jenschr/Teensy3.6-example/datasheets/T3.6_schematic.png

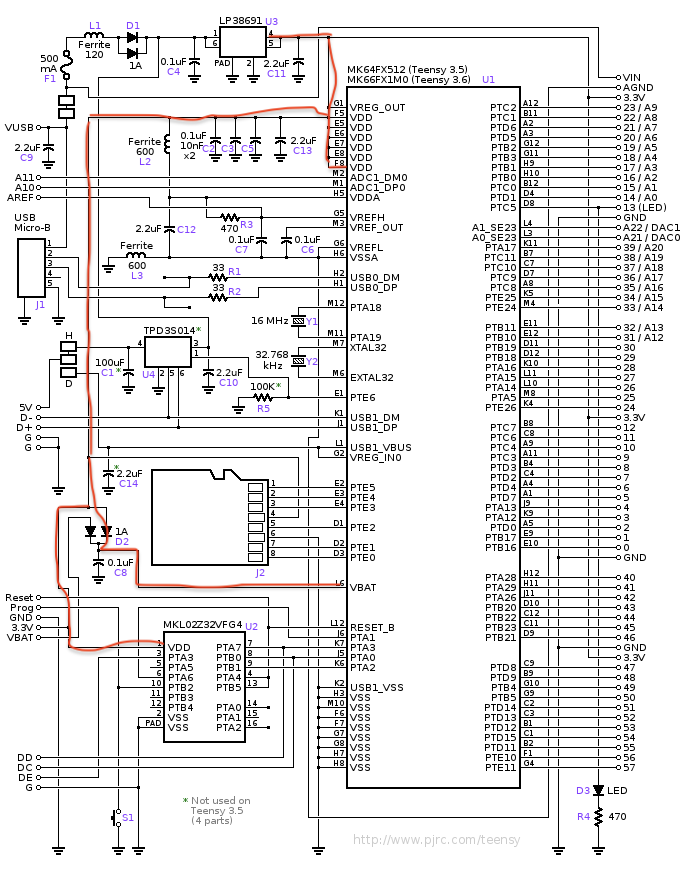
datasheets/T3.6_schematic.png
