jenschr/Teensy3.6-example/T3.6_schematic.pdf

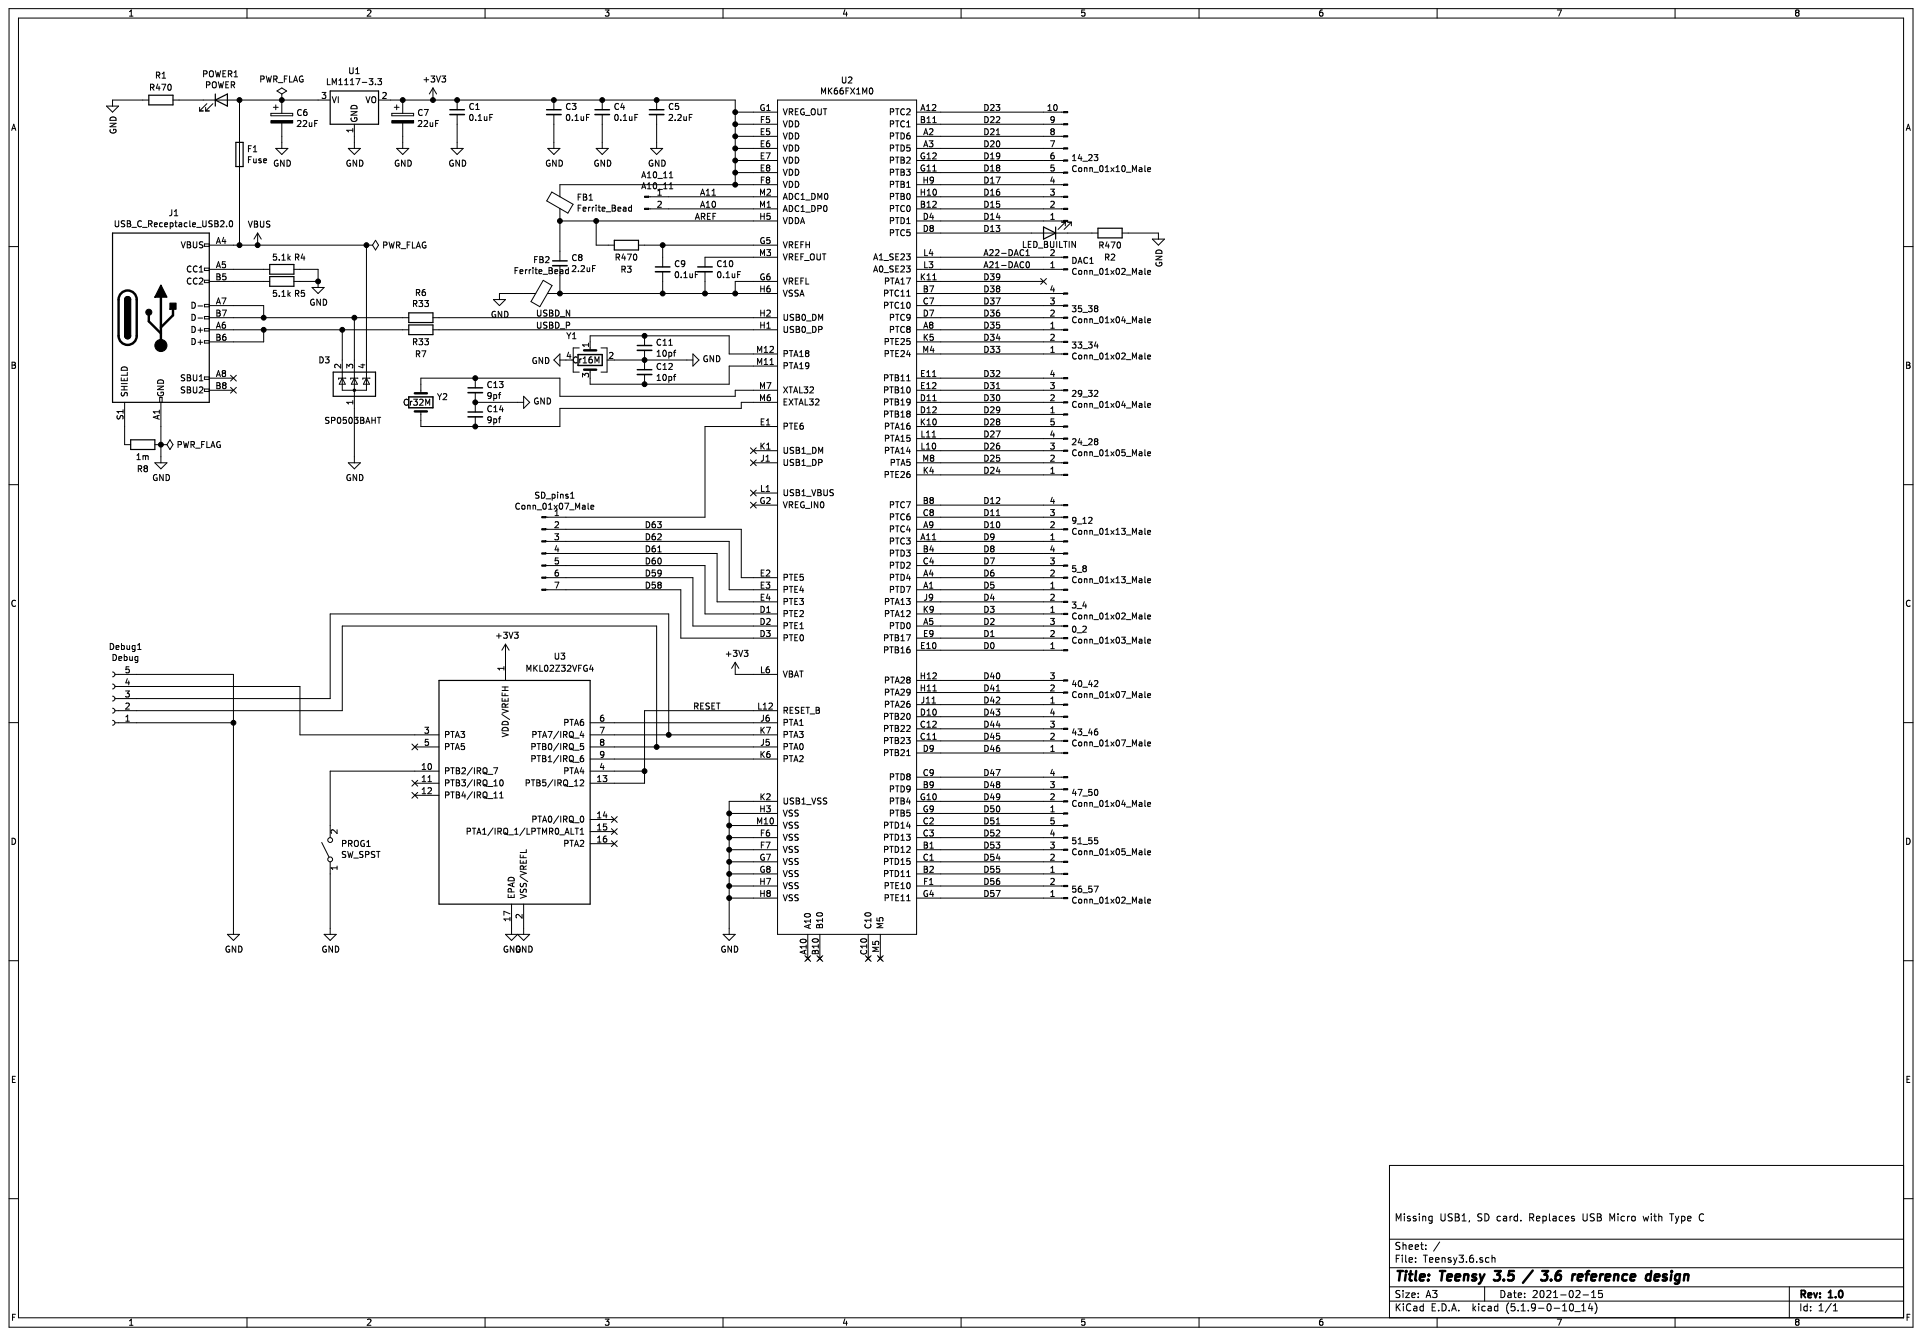
[picture p2: page 1]
