jenschr/Teensy3.6-example/Teensy3.6/Teensy3.6.kicad_pcb

## KiCad design Teensy3.6/Teensy3.6.kicad_pcb (2021-02-16)

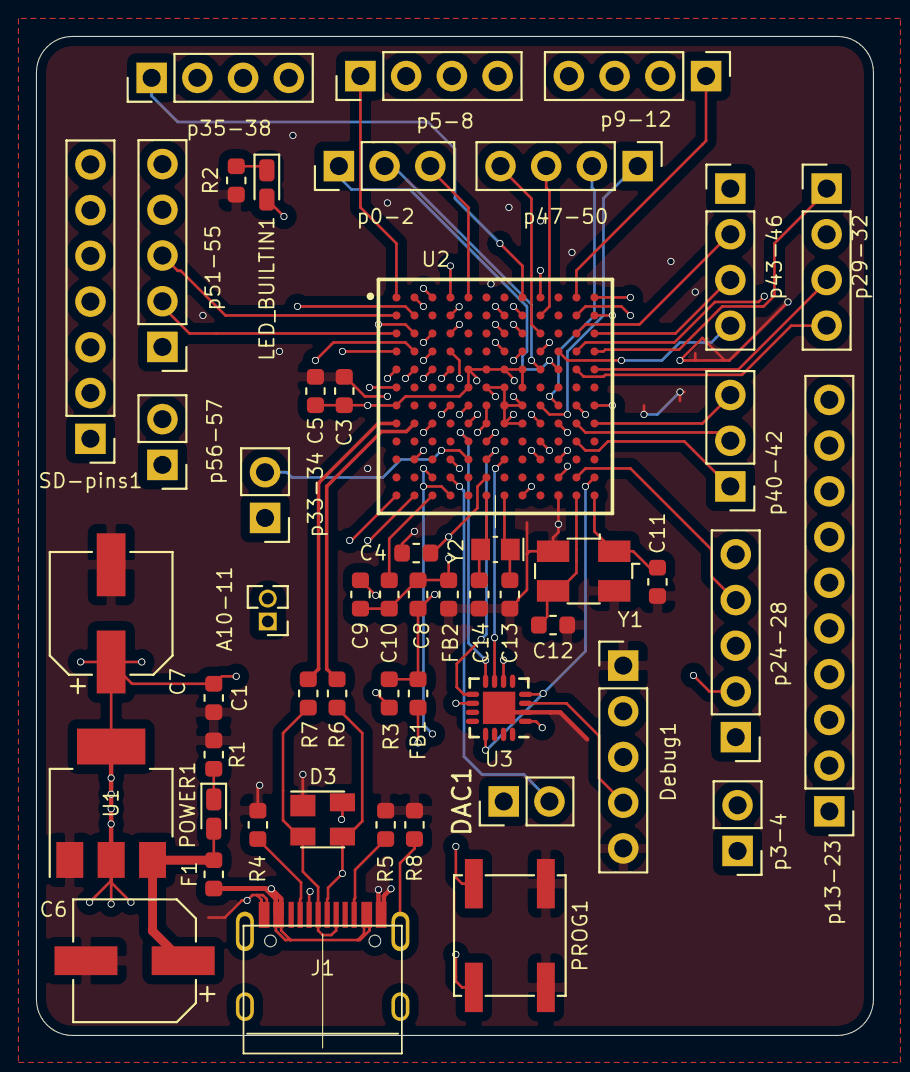
[picture p3: board Teensy3.6.kicad_pcb from above]

Board: 4 copper layers, 46.5 x 55.5 mm, 52 parts (0 on the bottom side), 96 nets.

Parts:
A10-11: A10-11; PinHeader_1x02_P1.27mm_Vertical
C1, C3, C4, C9, C10: 0.1uF; C_0603_1608Metric
C5, C8: 2.2uF; C_0603_1608Metric
C6, C7: 22uF; CP_Elec_6.3x7.7
C11, C12: 10pf; C_0603_1608Metric
C13, C14: 9pf; C_0603_1608Metric
D3: SP0503BAHT; SOT-143
DAC1: Conn_01x02_Male; PinHeader_1x02_P2.54mm_Vertical
Debug1: Debug; PinHeader_1x05_P2.54mm_Vertical
F1: Fuse; Fuse_0603_1608Metric
FB1, FB2: Ferrite_Bead; R_0603_1608Metric
J1: USB_C_Receptacle_USB2.0; TYPE-C-31-M-12
LED_BUILTIN1: LED_BUILTIN; LED_0603_1608Metric_Castellated
POWER1: POWER; LED_0603_1608Metric_Castellated
PROG1: SW_SPST; SW_SPST_EVQP0
R1, R2, R3: R470; R_0603_1608Metric
R4, R5: 5.1k; R_0603_1608Metric
R6, R7: R33; R_0603_1608Metric
R8: 1m; R_0603_1608Metric
SD-pins1: Conn_01x07_Male; PinHeader_1x07_P2.54mm_Vertical
U1: LM1117-3.3; SOT-223-3_TabPin2
U2: MK66FX1M0; BGA144C100P12X12_1300X1300X170
U3: MKL02Z32VFG4; QFN-16-1EP_3x3mm_P0.5mm_EP1.8x1.8mm
Y1: Cr16M; Crystal_SMD_Abracon_ABM3B-4Pin_5.0x3.2mm
Y2: Cr32M; Crystal_SMD_MicroCrystal_CM9V-T1A-2Pin_1.6x1.0mm_HandSolder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
p0-2: Conn_01x03_Male; PinHeader_1x03_P2.54mm_Vertical
p3-4, p33-34, p56-57: Conn_01x02_Male; PinHeader_1x02_P2.54mm_Vertical
p5-8, p9-12: Conn_01x13_Male; PinHeader_1x04_P2.54mm_Vertical
p13-23: Conn_01x10_Male; PinHeader_1x10_P2.54mm_Vertical
p24-28, p51-55: Conn_01x05_Male; PinHeader_1x05_P2.54mm_Vertical
p29-32, p35-38, p47-50: Conn_01x04_Male; PinHeader_1x04_P2.54mm_Vertical
p40-42: Conn_01x07_Male; PinHeader_1x03_P2.54mm_Vertical
p43-46: Conn_01x07_Male; PinHeader_1x04_P2.54mm_Vertical

Connections:
+3V3: C1.1, C3.1, C4.1, C5.1, C7.1, FB1.1, U1.2, U2.E5, U2.E6, U2.E7, U2.E8, U2.F5, U2.F8, U2.G1, U2.L6, U3.1
/A10: A10-11.2, U2.M1
/A11: A10-11.1, U2.M2
/A21-DAC0: DAC1.1, U2.L3
/A22-DAC1: DAC1.2, U2.L4
/AREF: C8.1, FB1.2, R3.2, U2.H5
/D0: U2.E10, p0-2.1
/D1: U2.E9, p0-2.2
/D2: U2.A5, p0-2.3
/D3: U2.K9, p3-4.1
/D4: U2.J9, p3-4.2
/D5: U2.A1, p5-8.1
/D6: U2.A4, p5-8.2
/D7: U2.C4, p5-8.3
/D8: U2.B4, p5-8.4
/D9: U2.A11, p9-12.1
/D10: U2.A9, p9-12.2
/D11: U2.C8, p9-12.3
/D12: U2.B8, p9-12.4
/D13: LED_BUILTIN1.2, U2.D8
/D14: U2.D4, p13-23.1
/D15: U2.B12, p13-23.2
/D16: U2.H10, p13-23.3
/D17: U2.H9, p13-23.4
/D18: U2.G11, p13-23.5
/D19: U2.G12, p13-23.6
/D20: U2.A3, p13-23.7
/D21: U2.A2, p13-23.8
/D22: U2.B11, p13-23.9
/D23: U2.A12, p13-23.10
/D24: U2.K4, p24-28.1
/D25: U2.M8, p24-28.2
/D26: U2.L10, p24-28.3
/D27: U2.L11, p24-28.4
/D28: U2.K10, p24-28.5
/D29: U2.D12, p29-32.1
/D30: U2.D11, p29-32.2
/D31: U2.E12, p29-32.3
/D32: U2.E11, p29-32.4
/D33: U2.M4, p33-34.1
/D34: U2.K5, p33-34.2
/D35: U2.A8, p35-38.1
/D36: U2.D7, p35-38.2
/D37: U2.C7, p35-38.3
/D38: U2.B7, p35-38.4
/D40: U2.H12, p40-42.3
/D41: U2.H11, p40-42.2
/D42: U2.J11, p40-42.1
/D43: U2.D10, p43-46.4
/D44: U2.C12, p43-46.3
/D45: U2.C11, p43-46.2
/D46: U2.D9, p43-46.1
/D47: U2.C9, p47-50.4
/D48: U2.B9, p47-50.3
/D49: U2.G10, p47-50.2
/D50: U2.G9, p47-50.1
/D51: U2.C2, p51-55.5
/D52: U2.C3, p51-55.4
/D53: U2.B1, p51-55.3
/D54: U2.C1, p51-55.2
/D55: U2.B2, p51-55.1
/D56: U2.F1, p56-57.2
/D57: U2.G4, p56-57.1
/RESET: U2.L12, U3.4, U3.13
/USBD_N: R6.1, U2.H2
/USBD_P: R7.1, U2.H1
GND: C1.2, C3.2, C4.2, C5.2, C6.2, C7.2, C11.2, C12.1, C13.2, C14.1, D3.1, Debug1.1, Debug1.5, FB2.1, J1.A1, J1.A12, J1.B1, J1.B12, PROG1.1, R1.1, R2.1, R4.1, R5.1, R8.1, U1.1, U2.F6, U2.F7, U2.G7, U2.G8, U2.H3, U2.H7, U2.H8, U2.K2, U2.M10, U3.2, U3.17, Y1.2, Y1.4
unnamed: C6.1, F1.1, POWER1.2, U1.3
unnamed: C9.1, R3.1, U2.G5
unnamed: C10.1, U2.M3
unnamed: C8.2, C9.2, C10.2, FB2.2, U2.G6, U2.H6
unnamed: C11.1, U2.M12, Y1.1
unnamed: C12.2, U2.M11, Y1.3
unnamed: C13.1, U2.M7, Y2.1
unnamed: C14.2, U2.M6, Y2.2
unnamed: D3.2, J1.A6, J1.B6, R7.2
unnamed: D3.3, J1.A7, J1.B7, R6.2
unnamed: Debug1.2, U2.J5, U3.8
unnamed: Debug1.3, U2.K7, U3.7
unnamed: Debug1.4, U3.3
unnamed: J1.A5, R4.2
unnamed: J1.B5, R5.2
unnamed: J1.S1, R8.2
unnamed: LED_BUILTIN1.1, R2.2
unnamed: POWER1.1, R1.2
unnamed: PROG1.2, U3.10
unnamed: SD-pins1.1, U2.E1
unnamed: SD-pins1.2, U2.E2
unnamed: SD-pins1.3, U2.E3
unnamed: SD-pins1.4, U2.E4
unnamed: SD-pins1.5, U2.D1
unnamed: SD-pins1.6, U2.D2
unnamed: SD-pins1.7, U2.D3
unnamed: U2.J6, U3.6
unnamed: U2.K6, U3.9
VBUS: D3.4, F1.2, J1.A4, J1.A9, J1.B4, J1.B9
