jenschr/Teensy3.6-example/(threads)

Thread 1 (2022-05-06):

no kicad .lib file that i can see

hbrezner, 2022-05-06:

jenschr, 2022-06-13:
Thanks for pointing this out! I've used a CPP .gitignore as a basis. Turns out that's a lousy solution for Kicad... #1

hbrezner, 2022-06-13:
as it turns out your mistake may have helped me. i was about to undertake a custom teensy layout, and dreading it, but i revisited the micromod format for teensy 4 and it may fit in my small board space. if it doesn't pan out then i'll be back on your design and roll a custom teensy.

Sent with [Proton Mail](https://proton.me/) secure email.

------- Original Message -------
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

Closed 2022-06-13.
