jenschr/Teensy3.6-example/(commit log)

2021-02-16 Board sent to fab
    [Teensy3.6.kicad_pcb, Teensy3.6.sch, Teensy3.6_EC.csv]
2021-03-17 Added pin numbers for the SD pins also
2021-03-17 Added image of the finished board
